farhan-shabab/WalkerBot-MakerKit/WalkerBot_Leg_Arrangement.png

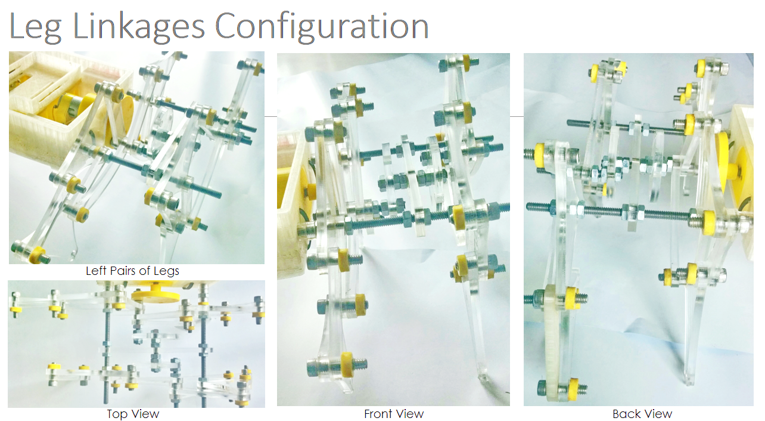
WalkerBot_Leg_Arrangement.png
