farhan-shabab/WalkerBot-MakerKit/Leg_linkage_proportions.png

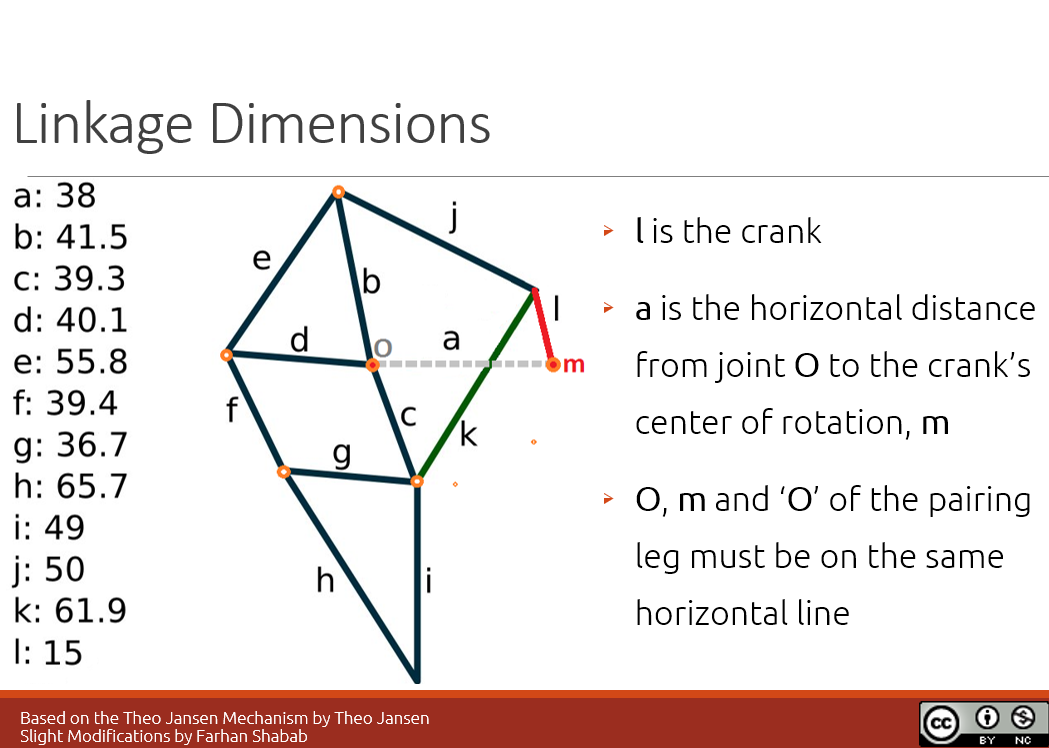
Leg_linkage_proportions.png
