farhan-shabab/WalkerBot-MakerKit/Leg_Linkages_LineDiagram_forLaserCutter.PNG

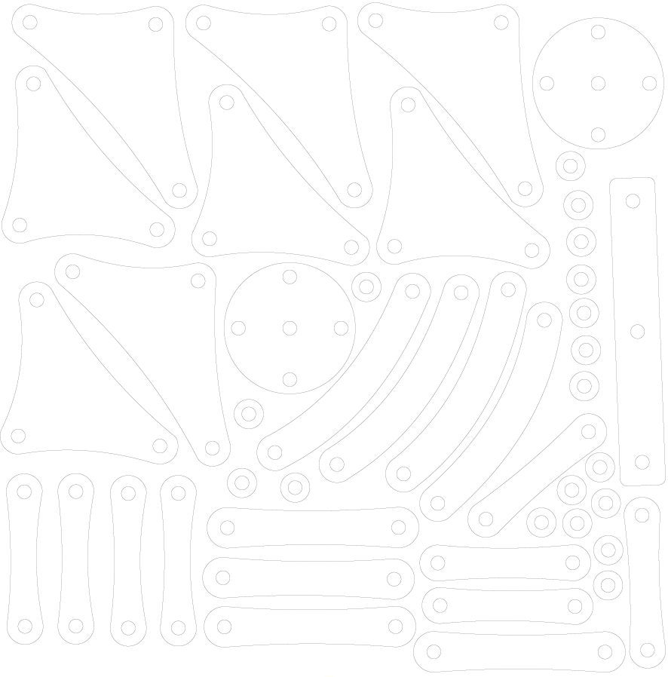
Leg_Linkages_LineDiagram_forLaserCutter.PNG
