farhan-shabab/WalkerBot-MakerKit/Parts_List.xlsx

Component | Part no./ Specification | Qty
DC Motors | RA27GM-02 | 2
Proximity Sensor | Keyes IR Sensor | 1
Microphone Sensor | Keyes Electret Microphone Sensor | 1
Switch | SPST switch | 1
LED | Yellow LED | 1
H Bridge | L293D Chip | 1
Microcontroller | Arduino Uno | 1
Breadboard |  | 1
Wires | Jumper Cables | 25
Leg Linkages | Laser Cut from 0.25" thick, 1 feet by feet acrylic plate | 48
Chassis | 3D Printed | 1
Motor Holder | 3D Printed | 2
Crank Connector | 3D Printed | 2
Electronics Housing | 3D Printed | 1
Threaded Rods | #8-32 12 | 6
Linkage Hex Bolts | #8-32 3/4 | 32
Linkage Nuts | 3D Printed | 32
Motor Holder Bolts | M8-16 | 10
Motor Holder Nuts | M8 | 10
Spacer Nuts | #8-32 | 46
 | NOTE: This list might not be exhaustive!
