farhan-shabab/WalkerBot-MakerKit/CAD Files/WalkerBot_Assembly.stp

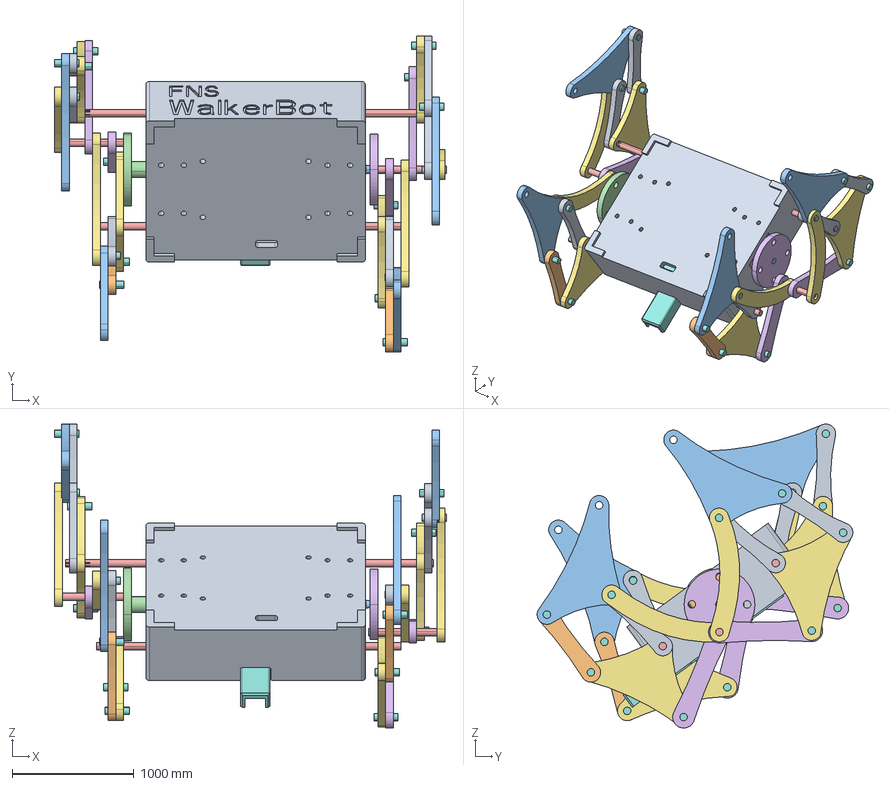
[picture p4: CAD file, 2015-12-12]
CAD Files/WalkerBot_Assembly.stp
3216.4 x 2590.7 x 2494.2 mm
MASSIVECHASSIS
MECHA_MOTOR_HOLDER x 2
MOTOR x 2
ARDAHOLDER
ROD x 4
CRANKMOTORCONNECT
SMALLDEL x 4
RODSMALL x 17
CLINK x 6
FLINK x 2
LARGEDEL x 4
CRANKCONNECTOR
RODMEDIUM x 2
JLINK x 4
KLINK x 4
BREADTOP2
