farhan-shabab/WalkerBot-MakerKit/CAD Files/motor_holder.stl

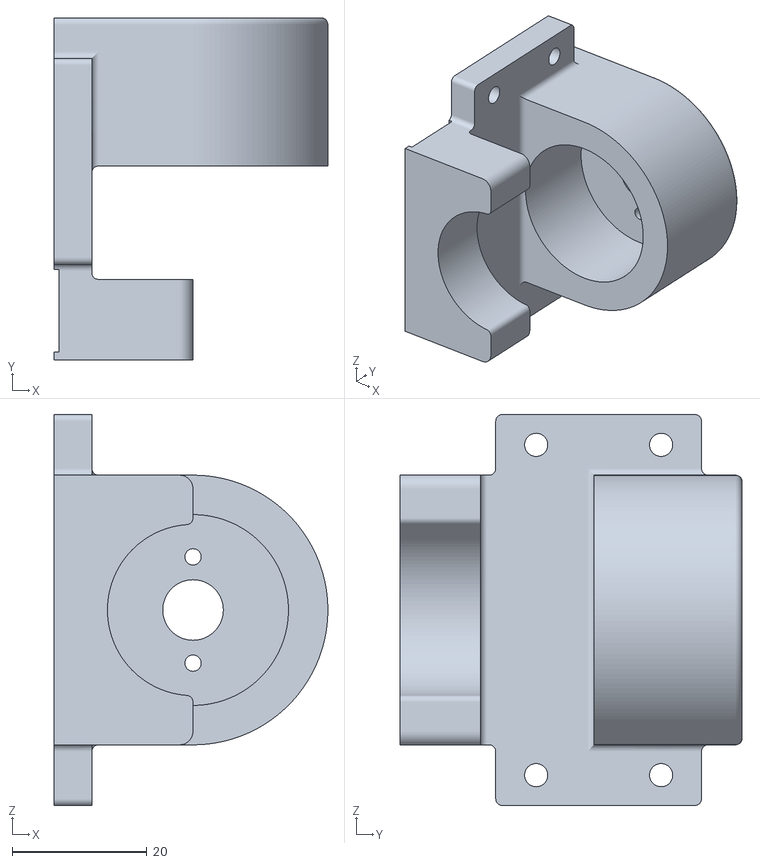
[picture p5: CAD file, 2015-12-12]
CAD Files/motor_holder.stl
40.6 x 50.8 x 58.0
