farhan-shabab/WalkerBot-MakerKit/CAD Files/crank_connector.stl

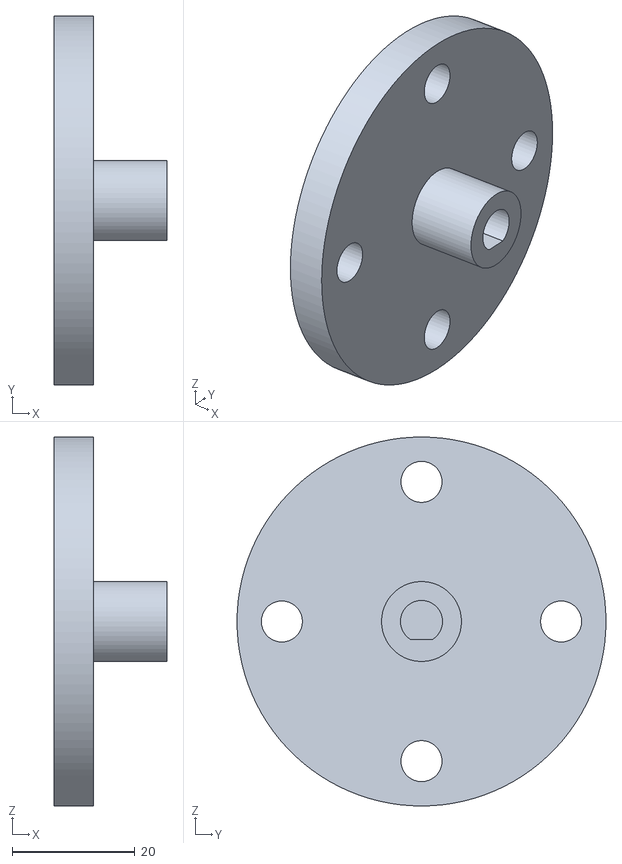
[picture p6: CAD file, 2015-12-12]
CAD Files/crank_connector.stl
18.3 x 60.0 x 60.0
