farhan-shabab/WalkerBot-MakerKit/CAD Files/arduino_holder.stl

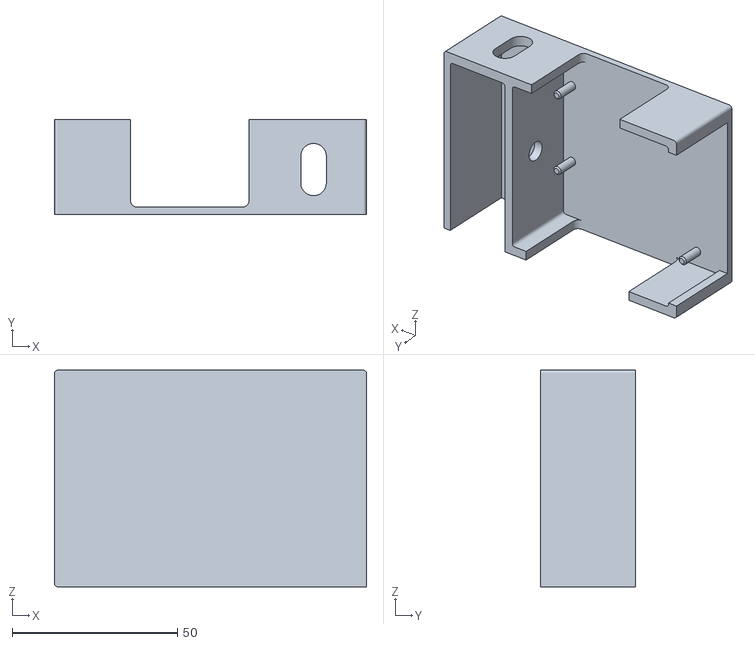
[picture p7: CAD file, 2015-12-12]
CAD Files/arduino_holder.stl
94.3 x 28.8 x 65.5
