farhan-shabab/WalkerBot-MakerKit/CAD Files/chassis.stl

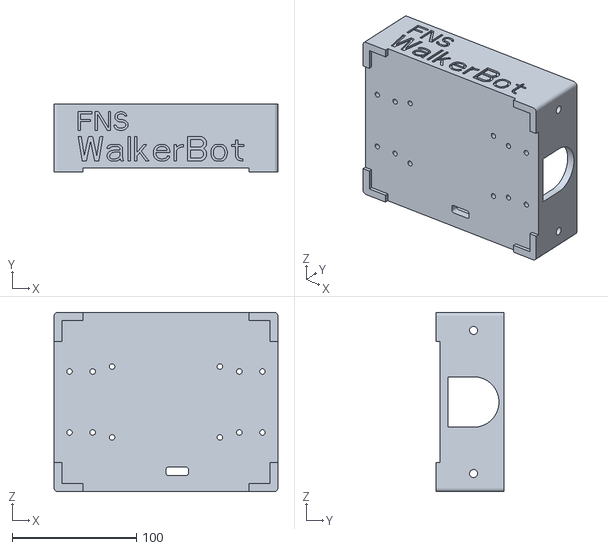
[picture p8: CAD file, 2015-12-12]
CAD Files/chassis.stl
180.0 x 54.5 x 144.0
