farhan-shabab/WalkerBot-MakerKit/CAD Files/breadboard_holder.stl

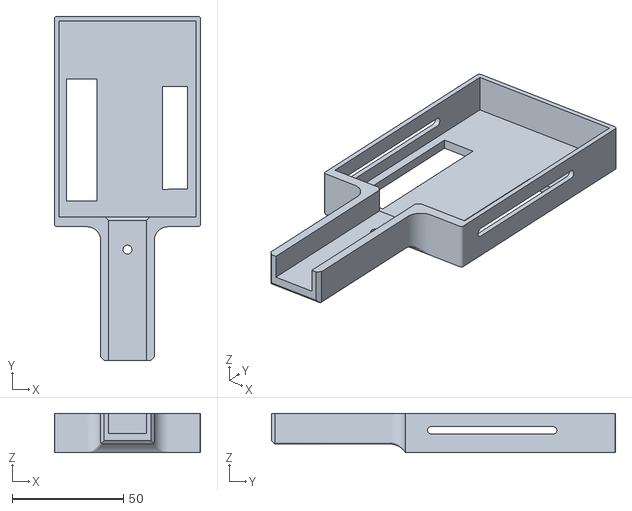
[picture p9: CAD file, 2015-12-12]
CAD Files/breadboard_holder.stl
65.5 x 154.3 x 17.5
