farhan-shabab/WalkerBot-MakerKit/WalkerBot_Wiring_Diagram.png

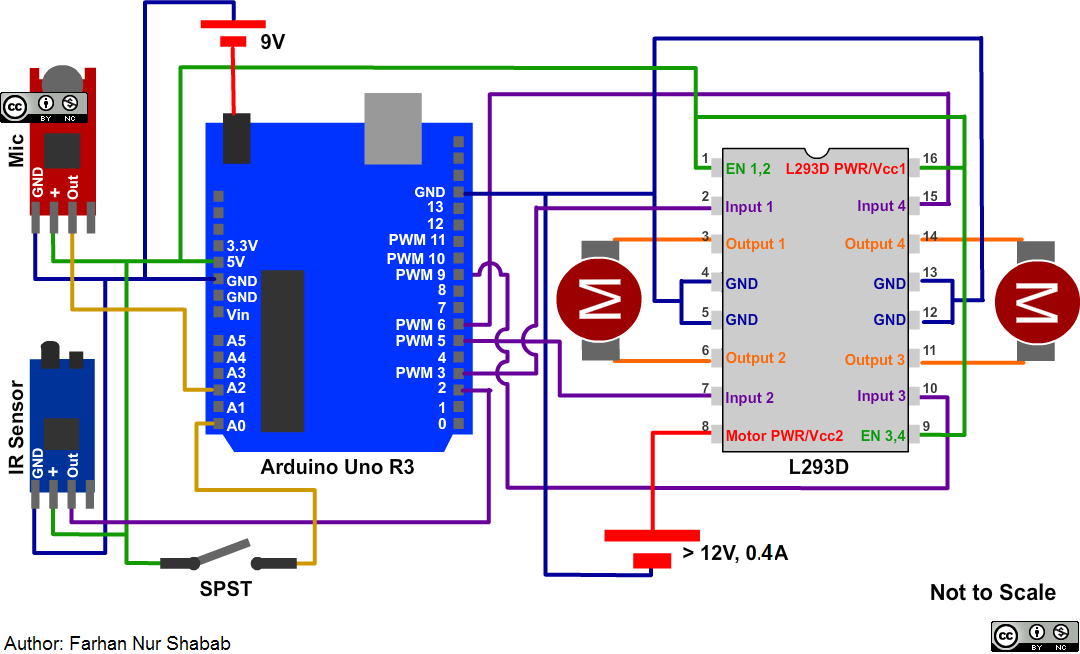
WalkerBot_Wiring_Diagram.png
